rprinz08/StickLock/doc/StickLock-schematic.pdf

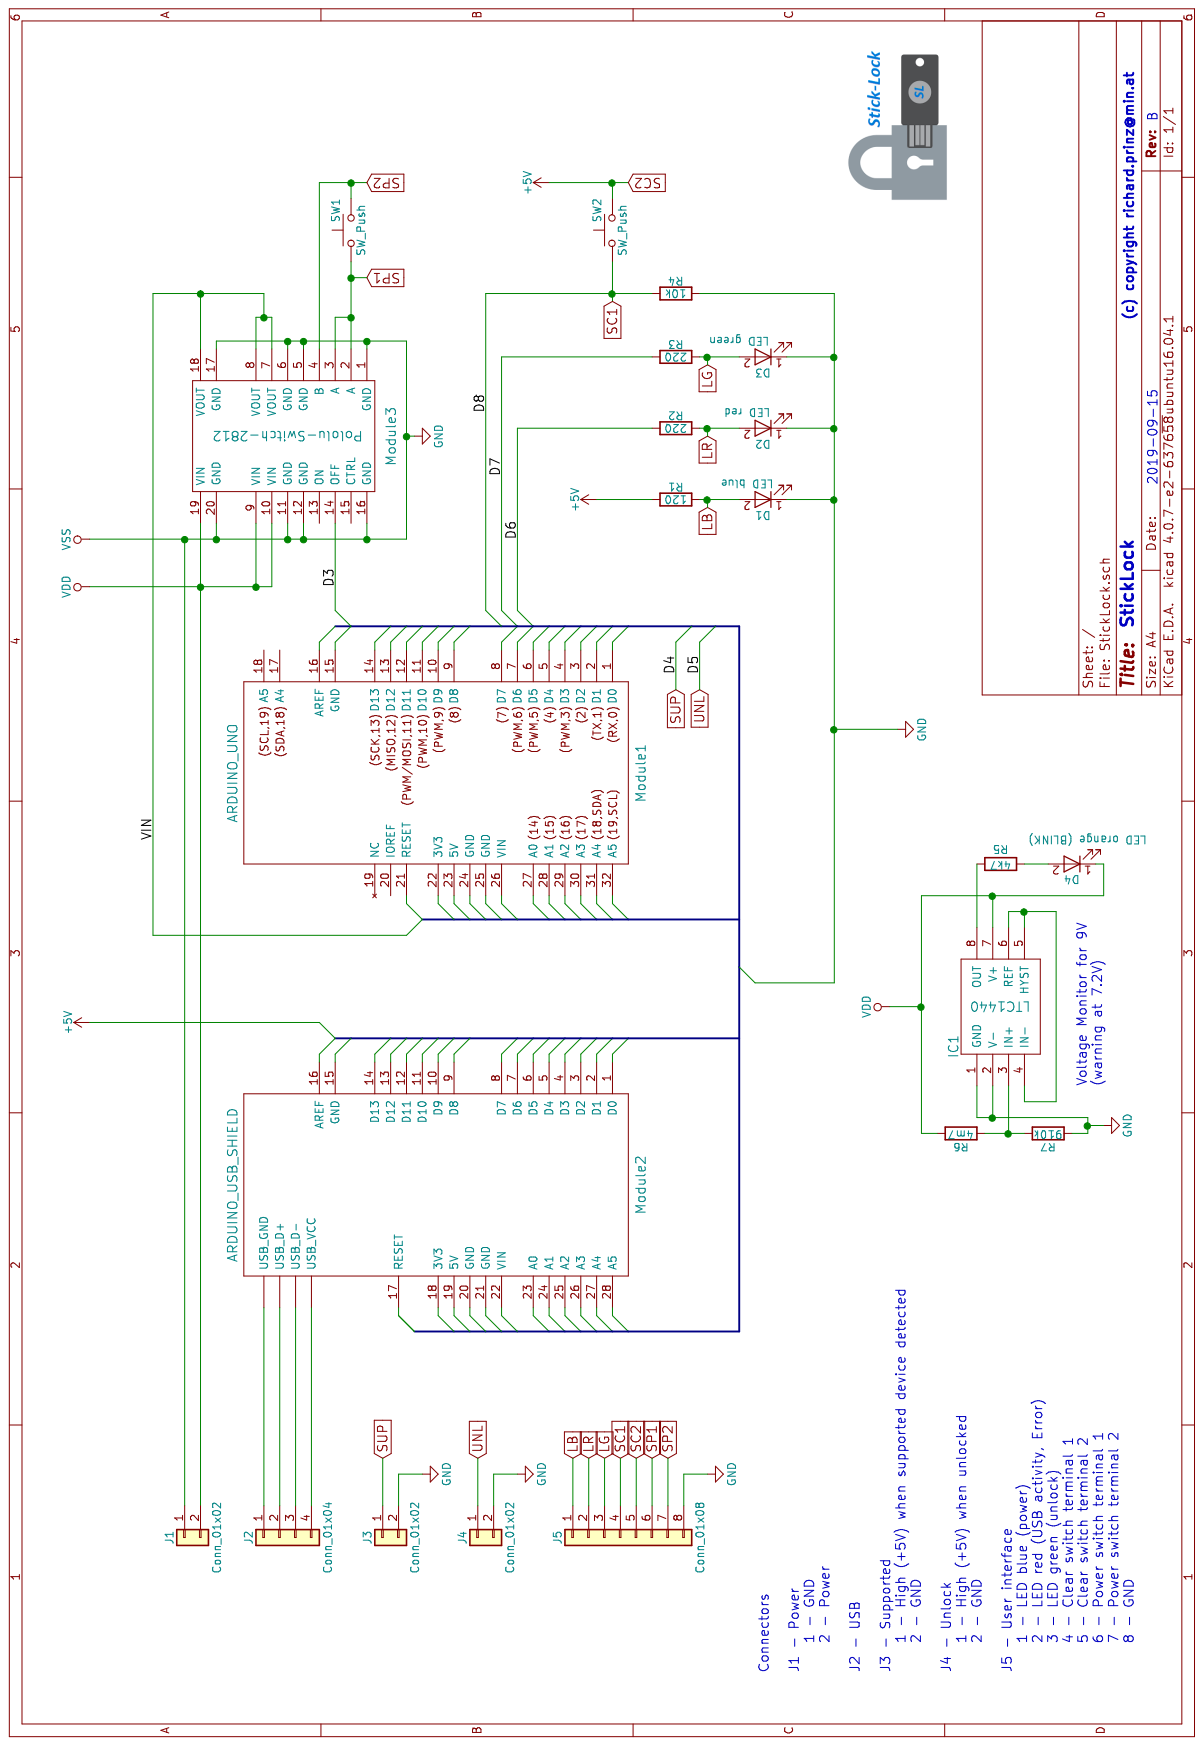
[picture p8: page 1]
