rprinz08/StickLock/(commit log)

2019-08-15 * New Key Type: Serial Number Only, PowerOff conf
2019-09-20 * Added battery monitor and power measurements
